Wi-Jan/BarnacleCleaning/GUI/version_info.txt

# UTF-8
#
# Windows VS_VERSION_INFO resource for HullVanguard.
# Embedded into both HullVanguard.exe and HullVanguard-Debug.exe by PyInstaller.

VSVersionInfo(
  ffi=FixedFileInfo(
    filevers=(1, 0, 0, 0),
    prodvers=(1, 0, 0, 0),
    mask=0x3f,
    flags=0x0,
    OS=0x40004,
    fileType=0x1,
    subtype=0x0,
    date=(0, 0),
  ),
  kids=[
    StringFileInfo(
      [
        StringTable(
          u'040904B0',
          [
            StringStruct(u'CompanyName', u'WEIJIAN'),
            StringStruct(u'FileDescription', u'HullVanguard — Barnacle Cleaning Robot Control'),
            StringStruct(u'FileVersion', u'1.0.0.0'),
            StringStruct(u'InternalName', u'HullVanguard'),
            StringStruct(u'LegalCopyright', u'© 2026 WEIJIAN. All rights reserved.'),
            StringStruct(u'OriginalFilename', u'HullVanguard.exe'),
            StringStruct(u'ProductName', u'HullVanguard'),
            StringStruct(u'ProductVersion', u'1.0.0.0'),
          ]
        )
      ]
    ),
    VarFileInfo([VarStruct(u'Translation', [1033, 1200])])
  ]
)
