Wi-Jan/BarnacleCleaning/docs/schematic-1-power-supply.png

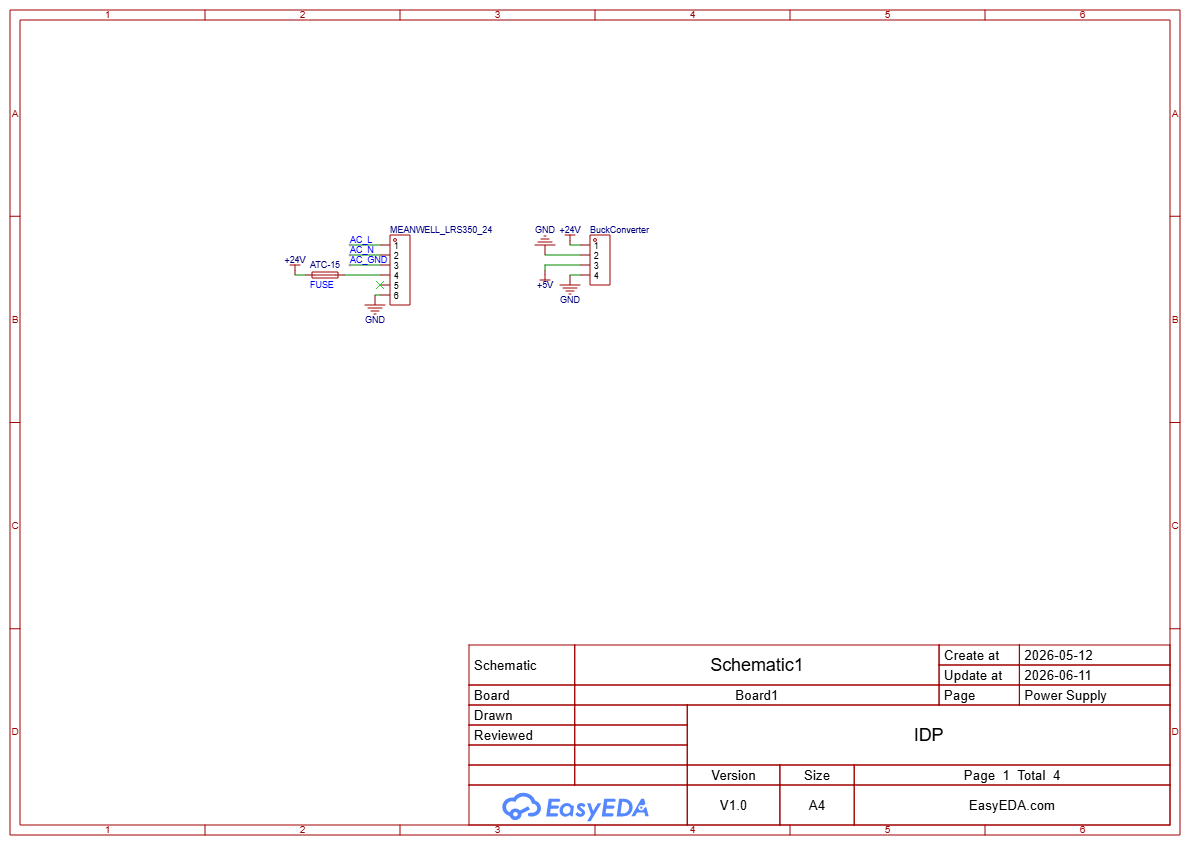
docs/schematic-1-power-supply.png
