Wi-Jan/BarnacleCleaning/docs/schematic-2-topside-control.png

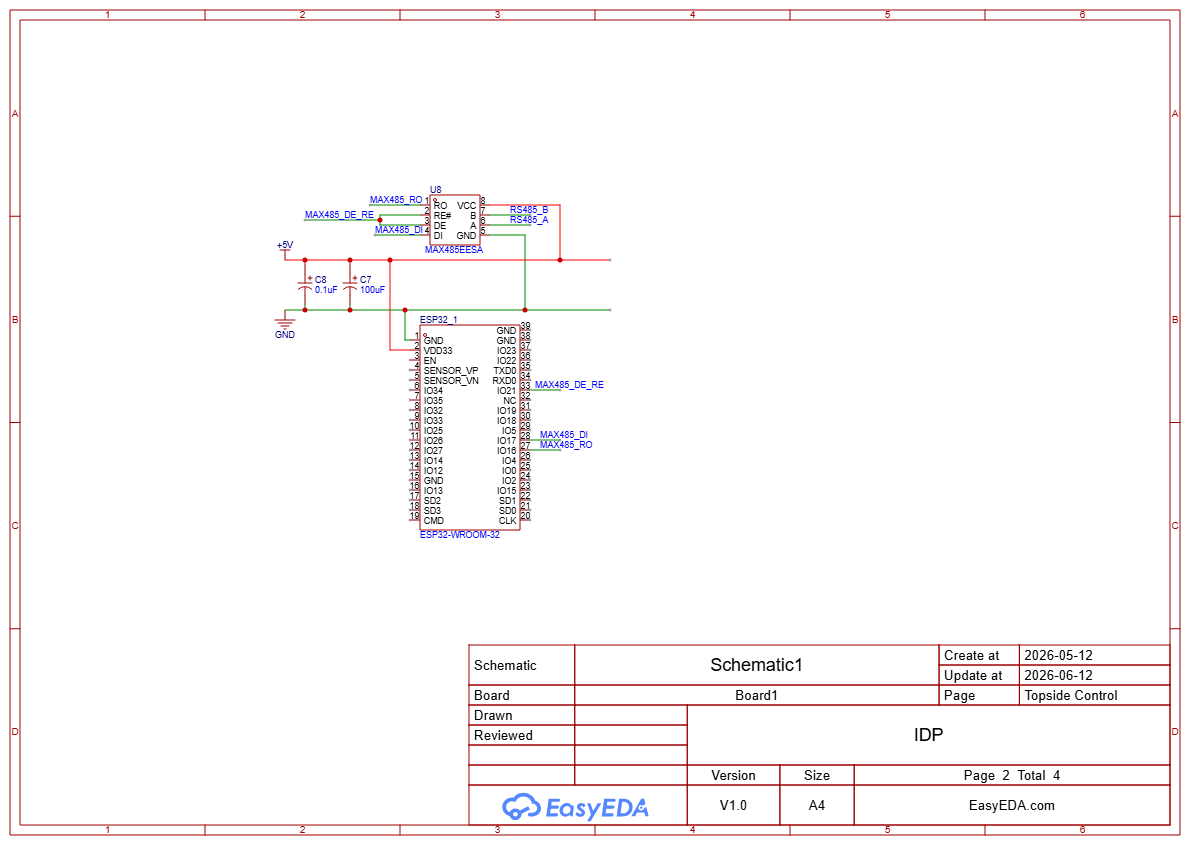
docs/schematic-2-topside-control.png
