Wi-Jan/BarnacleCleaning/docs/schematic-3-onboard-control.png

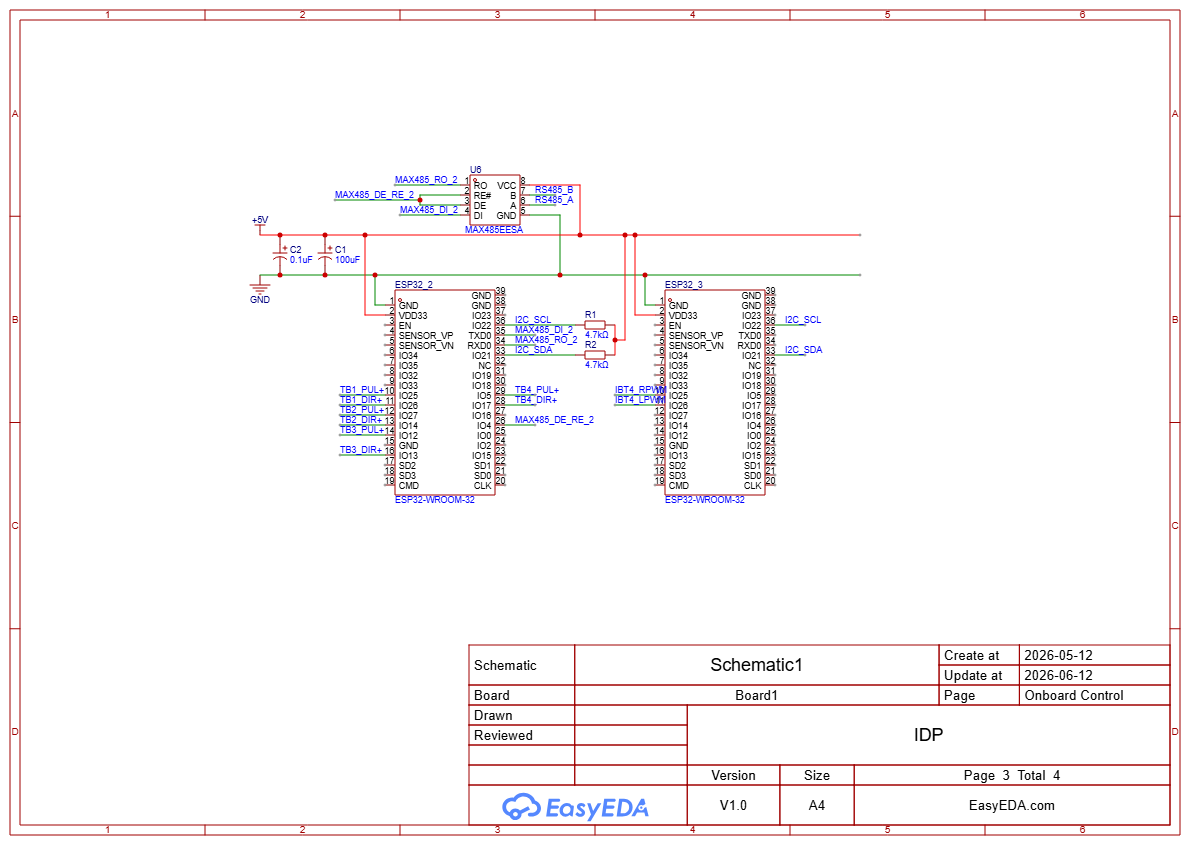
docs/schematic-3-onboard-control.png
