Wi-Jan/BarnacleCleaning/docs/schematic-4-motors.png

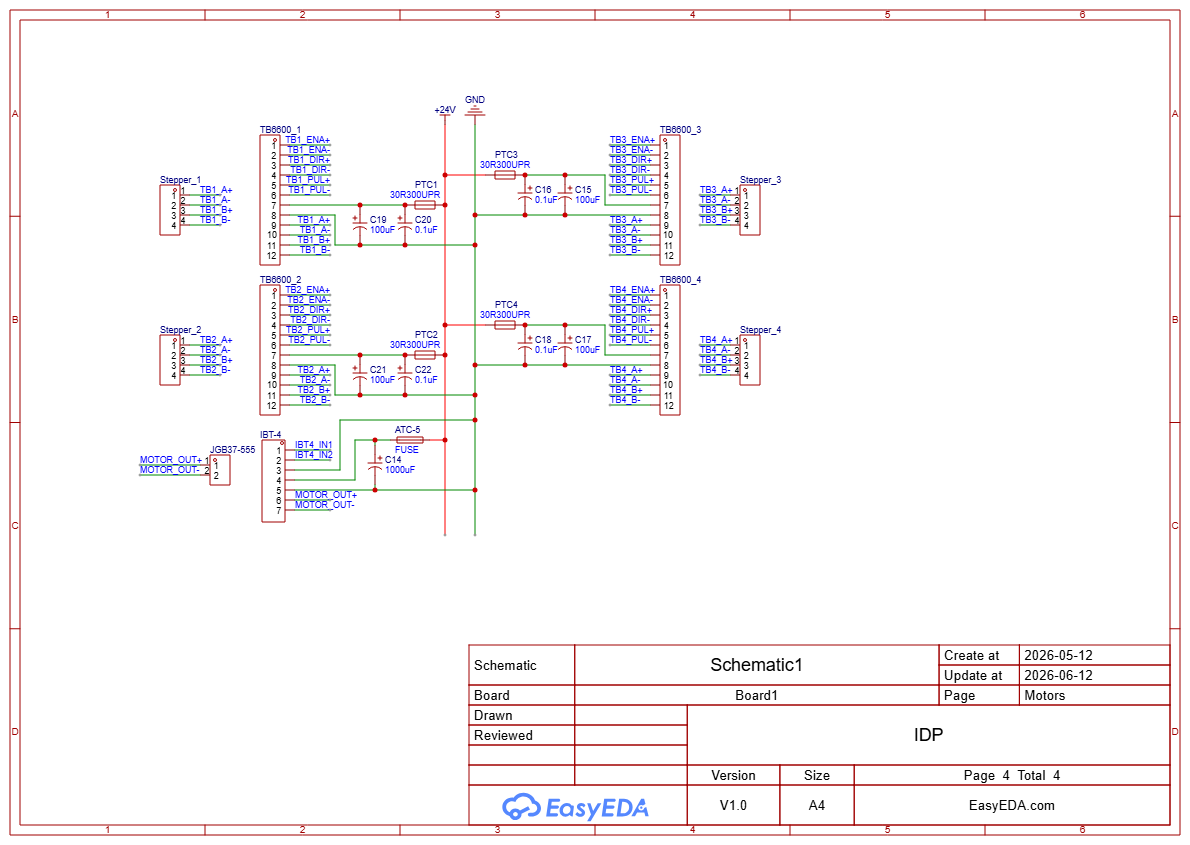
docs/schematic-4-motors.png
