Wi-Jan/BarnacleCleaning/SCH_Schematic1.pdf

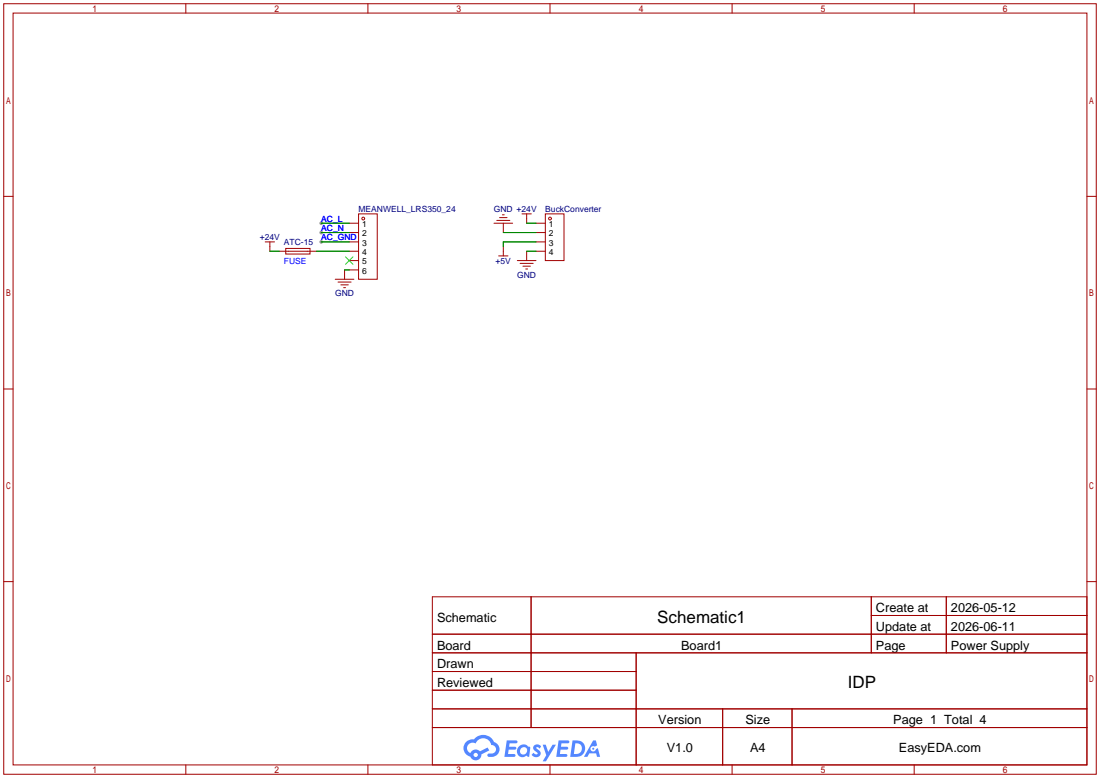
[picture p6: page 1]

Schematic | Schematic1 | Create at | 2026-05-12

Update at | 2026-06-11

Board | Board1 | Page | Power Supply
Drawn | | IDP
Reviewed

Version | Size | Page 1 Total 4
V1.0 | A4 | EasyEDA.com

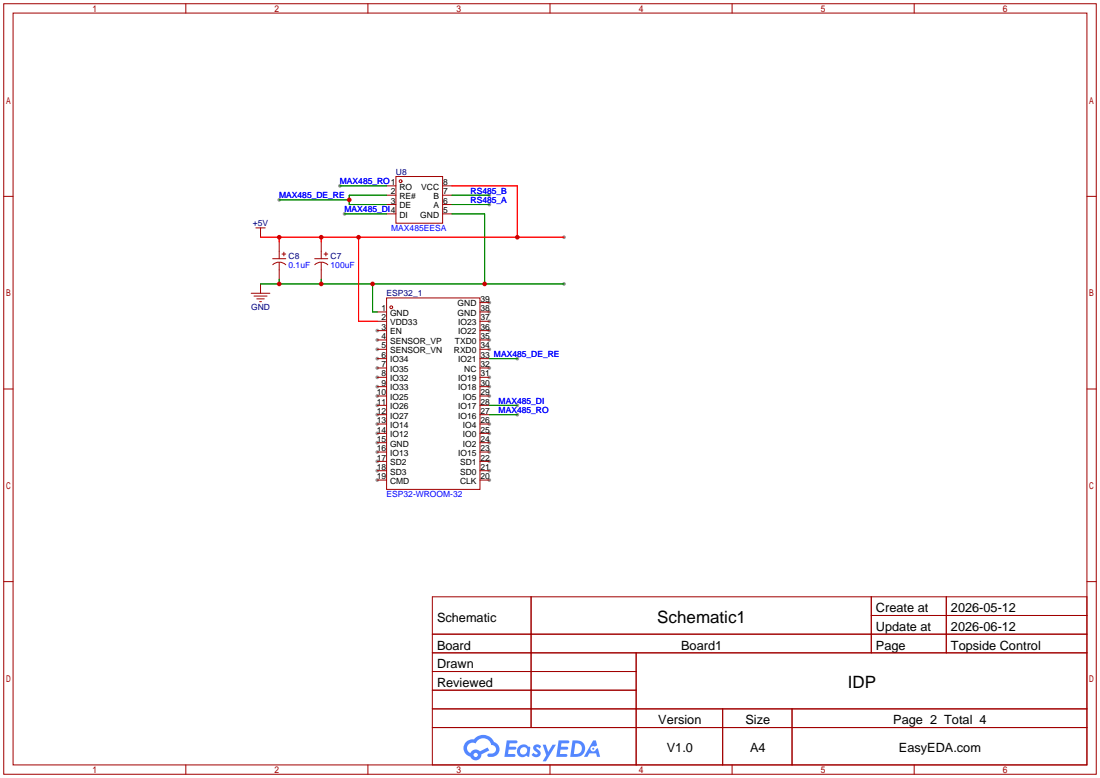
[picture p7: page 2]

Schematic | Schematic1 | Create at | 2026-05-12

Update at | 2026-06-12

Board | Board1 | Page | Topside Control
Drawn | | IDP
Reviewed

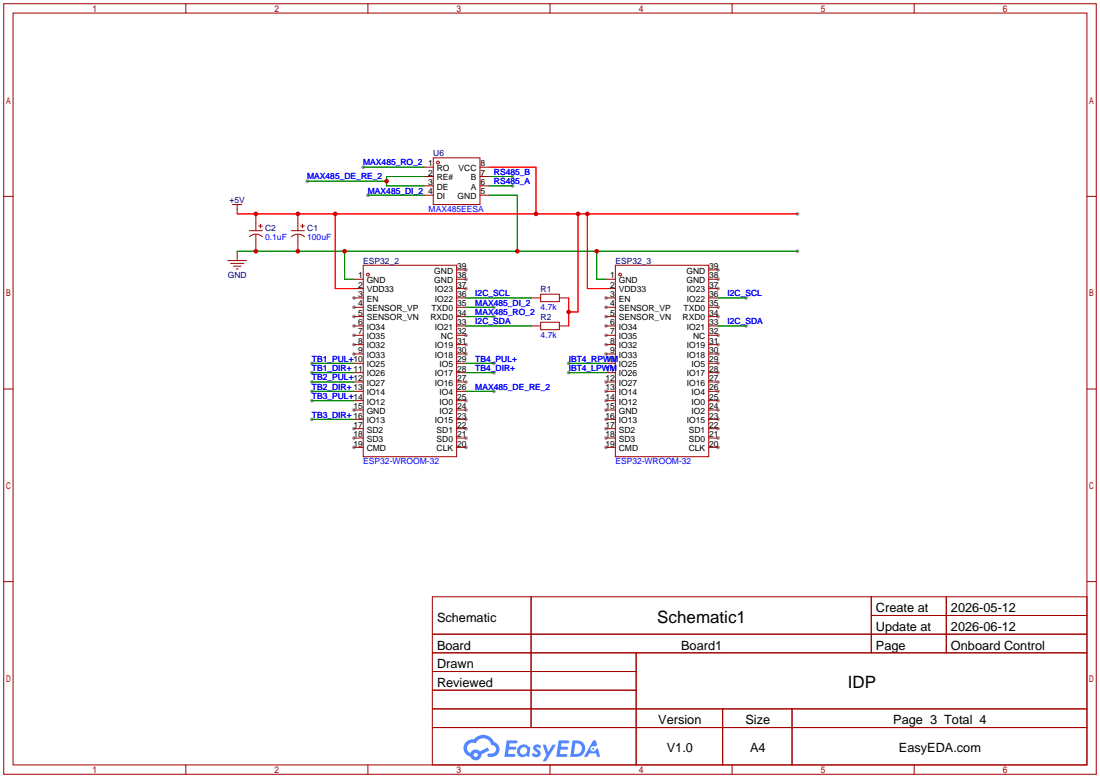
[picture p8: page 3]

Schematic | Schematic1 | Create at | 2026-05-12

Update at | 2026-06-12

Board | Board1 | Page | Onboard Control
Drawn | | IDP
Reviewed

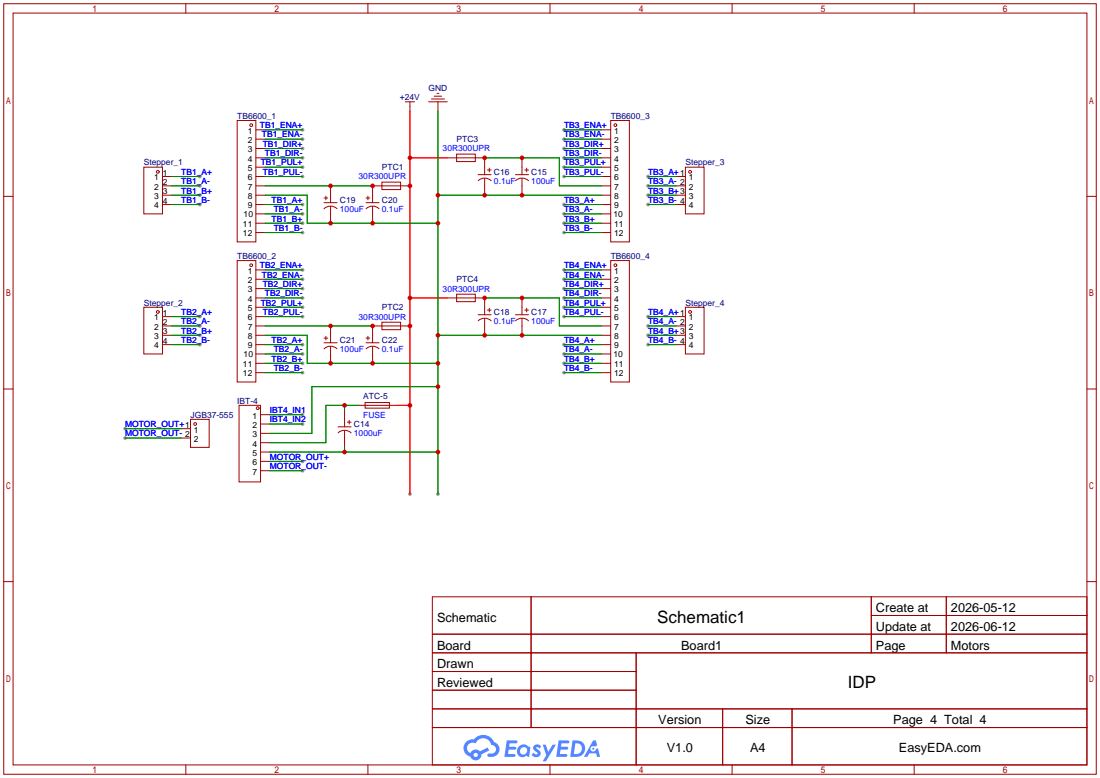
[picture p9: page 4]

Schematic | Schematic1 | Create at | 2026-05-12

Update at | 2026-06-12

Board | Board1 | Page | Motors
Drawn | | IDP
Reviewed
