Wi-Jan/BarnacleCleaning/(commit log)

2026-09-29 Initial commit: Barnacle Cleaning Robot (HullVanguard)
    Source for the KIG3011 IDP2 Track 3 Group 36 hull-climbing barnacle
    cleaning robot: four ESP32 firmware targets, the HullVanguard desktop
    control station, the YOLO training script and the wiring reference.
    Build artefacts (GUI/dist, GUI/build, GUI/installer_output), trained
    weights, AI/runs and the third-party Roboflow dataset images are
    excluded via .gitignore — about 6.6 GB of the working folder.
    Dataset paths in AI/barnacles_dataset/data.yaml changed from absolute
    local paths to relative ones so training works on any machine.
    Claude-Session: https://claude.ai/code/session_01PR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
2026-09-29 Add docs/ with schematics and labelled robot render
    Four EasyEDA schematic exports plus the full-system SVG, and the labelled
    CAD render from the project poster as the README hero image.
    Claude-Session: https://claude.ai/code/session_01PRchkJo2weyNTVGwAuuWbj
